Thbetyfu/Peruri-Chip-Satria-Chip/hardware-satria/rtl_sv/README.md

# RTL SystemVerilog

Padanan SystemVerilog dari `../rtl/*.v` (modul, port, dan perilaku identik).
Uji: `HDL=sv python tb/run.py [core|uart|random]`. Hasil verifikasi:
`../docs/verifikasi_sv.md`.
