Thbetyfu/Peruri-Chip-Satria-Chip/hardware-satria/docs/skematik/01_RTL_top_level.pdf

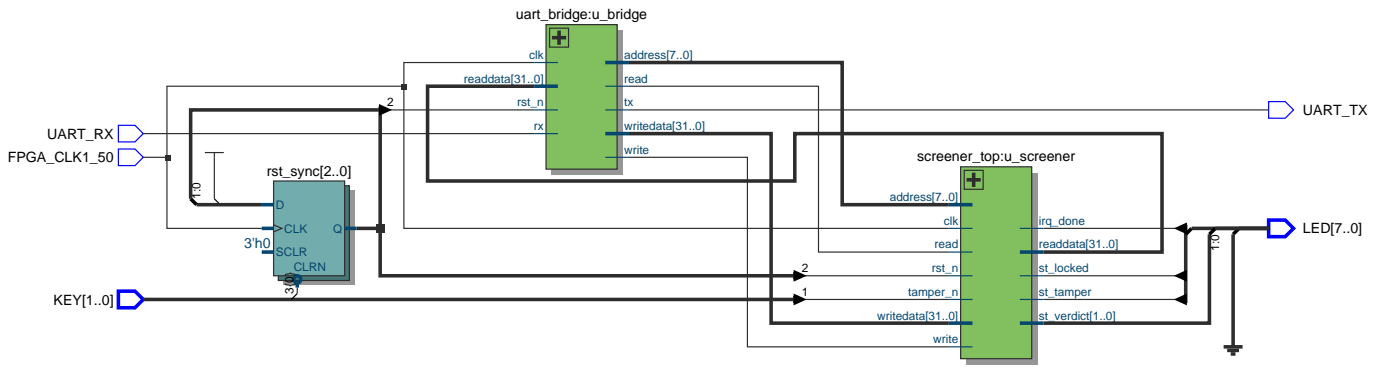
[picture p2: figure]
UART_RX FPGA_CLK1_50; KEY[1..0]; rst_sync[2..0] D; CLK; CLRN; SCLR 3'h0; uart_bridge:u_bridge; clk; rst_n; readdata[31..0]; read; write; address[7..0]; writedata[31..0]; screener_top:u_screener; tamper_n; irq_done; st_locked; st_tamper; st_verdict[1..0]; UART_TX; LED[7..0]
