Thbetyfu/Peruri-Chip-Satria-Chip/hardware-satria/docs/skematik/03_PostFit_top_level.pdf

### KEY[0..1]

### FPGA_CLK1_50

### UART_RX

### FPGA_CLK1_50~input

IO_IBUF I | O

### FPGA_CLK1_50~inputCLKENA0

### CLKCTRL

INCLK OUTCLK

### rst_sync[0]~feeder

### LOGIC_CELL_COMB

COMBOUT

### KEY[0]~input

IO_IBUF I | O

### rst_sync[0]

CLK

D
CLRN

Q

### rst_sync[1]

CLK

SDATA

CLRN

SLOAD 1'h1

Q

### rst_sync[2]

CLK

SDATA

CLRN

SLOAD 1'h1

Q

### rst_sync[2]~CLKENA0

### CLKCTRL

INCLK OUTCLK

### UART_RX~input

IO_IBUF I | O

### KEY[1]~input

IO_IBUF I | O

### uart_bridge:u_bridge

FPGA_CLK1_50~inputCLKENA0

rst_sync[2]~CLKENA0

screener_top:u_screener:readdata[0..31]

UART_RX~input

address[0..1]

address[2..7]

address[1]~DUPLICATE

read

tx

write

writedata[0..3]

writedata[5..7]

writedata[8..9]

writedata[11..18]

writedata[19..23]

writedata[25..31]

writedata[3]~DUPLICATE

writedata[4]

writedata[4]~DUPLICATE

writedata[7]~DUPLICATE

writedata[9]~DUPLICATE

writedata[10]

writedata[10]~DUPLICATE

writedata[18]~DUPLICATE

writedata[23]~DUPLICATE

writedata[24]

writedata[24]~DUPLICATE

writedata[31]~DUPLICATE

### ~GND

### LOGIC_CELL_COMB

COMBOUT

### screener_top:u_screener

FPGA_CLK1_50~inputCLKENA0 KEY[1]~input

rst_sync[2]~CLKENA0

uart_bridge:u_bridge:address[0..1]

uart_bridge:u_bridge:address[2..7] uart_bridge:u_bridge:address[1]~DUPLICATE

uart_bridge:u_bridge:read

uart_bridge:u_bridge:write uart_bridge:u_bridge:writedata[0..3]

uart_bridge:u_bridge:writedata[5..7]

uart_bridge:u_bridge:writedata[8..9]

uart_bridge:u_bridge:writedata[11..18]

uart_bridge:u_bridge:writedata[19..23]

uart_bridge:u_bridge:writedata[25..31] uart_bridge:u_bridge:writedata[3]~DUPLICATE

uart_bridge:u_bridge:writedata[4] uart_bridge:u_bridge:writedata[4]~DUPLICATE

uart_bridge:u_bridge:writedata[7]~DUPLICATE

uart_bridge:u_bridge:writedata[9]~DUPLICATE

uart_bridge:u_bridge:writedata[10] uart_bridge:u_bridge:writedata[10]~DUPLICATE

uart_bridge:u_bridge:writedata[18]~DUPLICATE

uart_bridge:u_bridge:writedata[23]~DUPLICATE

uart_bridge:u_bridge:writedata[24] uart_bridge:u_bridge:writedata[24]~DUPLICATE

uart_bridge:u_bridge:writedata[31]~DUPLICATE

~GND

done_flag

key_vault:u_vault:locked

key_vault:u_vault:tamper

readdata[0..31]

verdict[0..1]

### UART_TX~output

IO_OBUF I | O

### LED[2]~output

IO_OBUF I | O

### LED[3]~output

IO_OBUF I | O

### LED[7]~output

IO_OBUF I | O

### LED[0]~output

IO_OBUF I | O

### LED[1]~output

IO_OBUF I | O

### LED[4]~output

IO_OBUF I 1'h0 | O

### LED[5]~output

IO_OBUF I 1'h0 | O

### LED[6]~output

IO_OBUF I 1'h0 | O

### UART_TX

### LED[0..7]

0 | 1 | 01
