Thbetyfu/Peruri-Chip-Satria-Chip/hardware-satria/docs/skematik/04_PostFit_rule_engine_gerbang.pdf

# rule_engine:u_rule

# cfg_amt_hi[4..29] cfg_amt_hi[2..3]~DUPLICATE

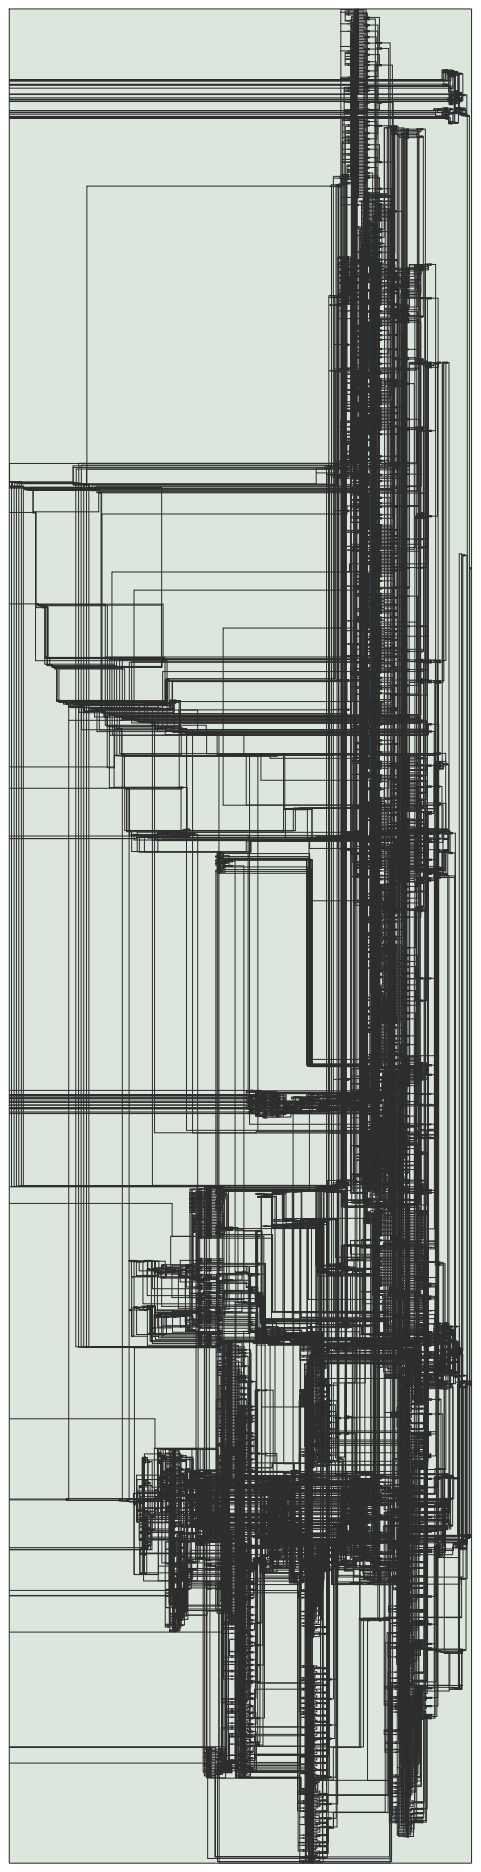
[picture p3: page 1]
acct_idx[0..37]; acct_idx[39..47]; acct_idx[37]~DUPLICATE; acct_idx[38]; acct_idx[38]~DUPLICATE; cfg_amt_hi[0]~DUPLICATE; cfg_amt_hi[1]; cfg_amt_hi[30]~DUPLICATE; cfg_amt_hi[31] cfg_amt_lo[0..12] cfg_amt_lo[13..14]; cfg_amt_lo[16..19] cfg_amt_lo[21..28]; cfg_amt_lo[29..31]; cfg_amt_lo[12]~DUPLICATE; cfg_amt_lo[15]~DUPLICATE; cfg_amt_lo[20]~DUPLICATE; cfg_amt_lo[28]~DUPLICATE; cfg_vel[0..15]; cfg_window[1..3]; cfg_window[0]; cfg_window[0]~DUPLICATE; cfg_window[3]~DUPLICATE; cfg_window[4]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

DATAA DATAB DATAC
LessThan5~27
DATAD

LOGIC_CELL_COMB
LessThan5~7

LessThan5~28

COUT SUMOUT Add4~17
CIN 1'h0 DATAA DATAC
COUT SUMOUT
COUT SUMOUT Add6~17

COUT SUMOUT Add2~9
CIN 1'h0 DATAA DATAD
CIN
DATAA DATAC
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
