Thbetyfu/Peruri-Chip-Satria-Chip/fig/block_diagram.png

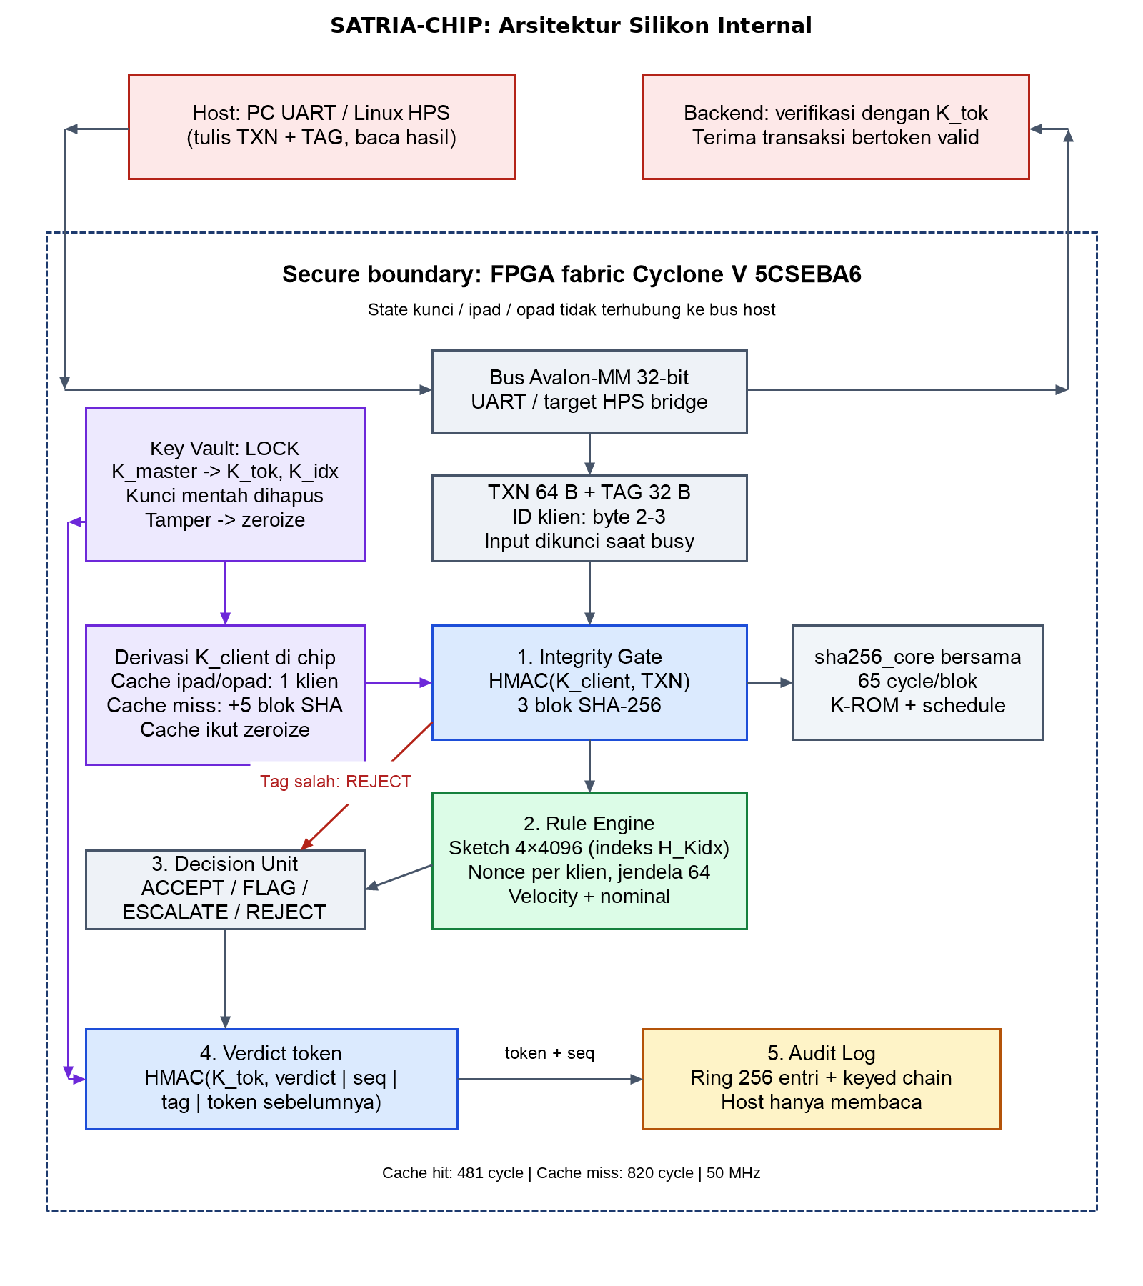
fig/block_diagram.png
