Thbetyfu/Peruri-Chip-Satria-Chip/fig/timing_transaksi.png

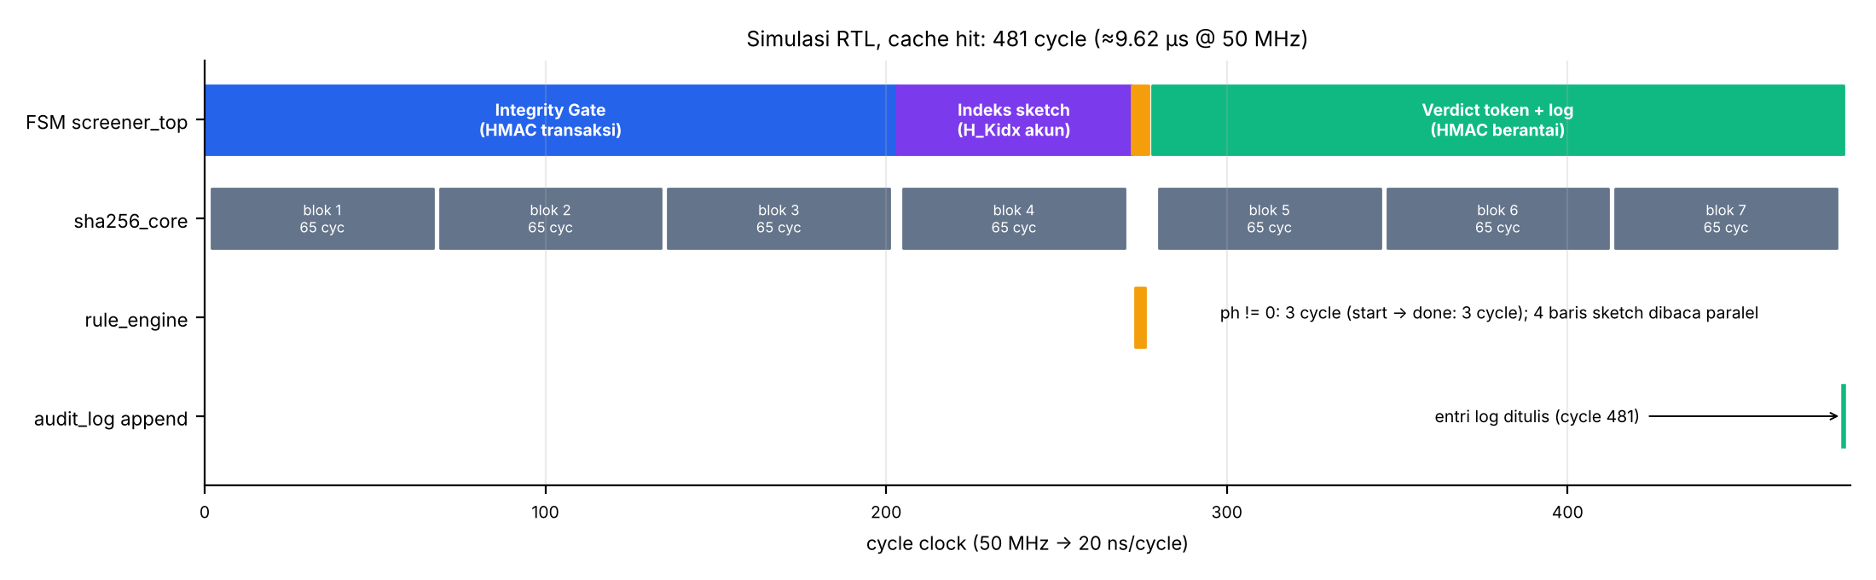
fig/timing_transaksi.png
