Thbetyfu/Peruri-Chip-Satria-Chip/hardware-satria/docs/skematik/04_cuplikan_zoom_rule_engine.png

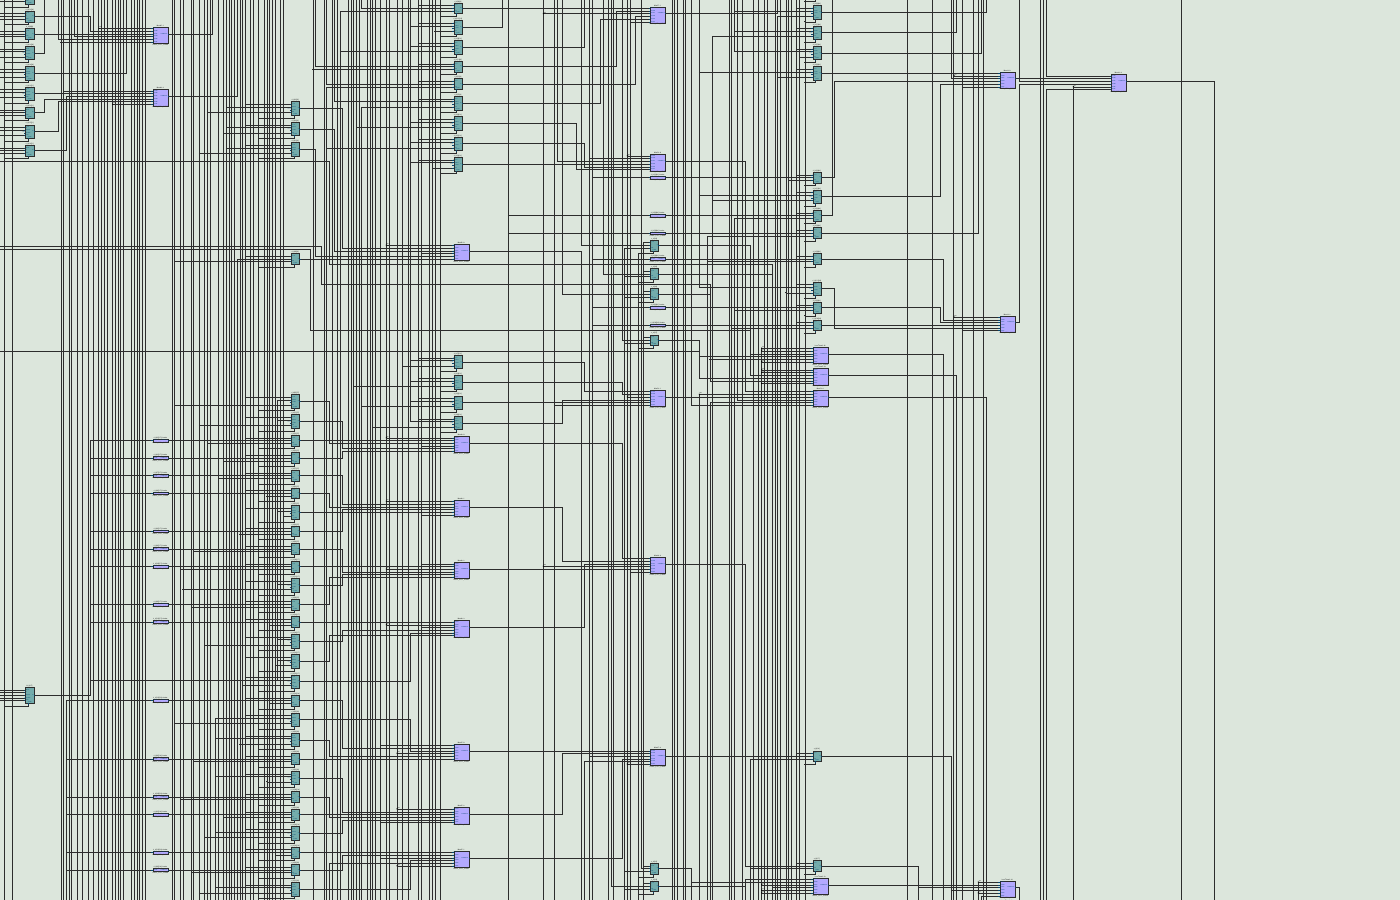
hardware-satria/docs/skematik/04_cuplikan_zoom_rule_engine.png
