Thbetyfu/Peruri-Chip-Satria-Chip/hardware-satria/docs/skematik/02_RTL_screener_top_lengkap.pdf

# screener_top:u_screener

KEY[1..0] | LED[7..0] UART_RX | UART_TX

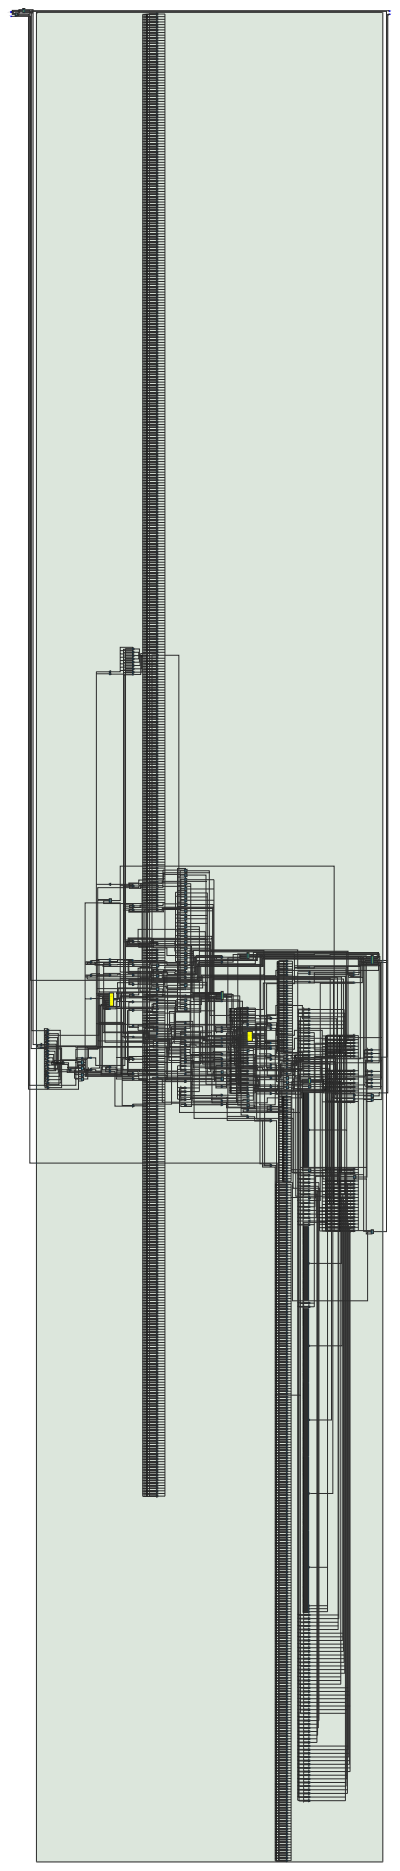
[picture p7: page 1]
clk; read; rst_n; tamper_n; write; address[7..0]; writedata[31..0]; irq_done; st_locked; st_tamper; readdata[31..0]; st_verdict[1..0]; rst_sync[2..0] D; CLKCLRN; SCLR 3'h0; uart_bridge:u_bridge; txwrite; address[7..0] writedata[31..0]; 1'h0 CIN; Add0; OUT[31..0]; Decoder0; OUT[15..0]; Decoder1; OUT[7..0]; Decoder2; OUT[3..0]; Decoder3; OUT[255..0] =Equal0; OUT; =Equal1; =Equal2; =Equal3; OUT =Equal4; OUT =Equal5; OUT =Equal6; OUT =Equal7; =Equal8; OUT =Equal9; =Equal10; OUT <; 1'h1 CIN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
