Thbetyfu/Peruri-Chip-Satria-Chip/hardware-satria/rtl_sv/uart_bridge.sv

// SPDX-License-Identifier: LicenseRef-Proprietary
// SPDX-FileCopyrightText: Copyright (c) 2026 Tim Paket Kulit 12k, Telkom University. All rights reserved.
// uart_bridge.v - jembatan UART 8N1 -> bus register screener (untuk demo PC).
//
// Protokol (byte):
//   Tulis: 'W' addr d3 d2 d1 d0   -> balasan 'K'
//   Baca : 'R' addr               -> balasan d3 d2 d1 d0
// Pada DE10-Nano produksi, jembatan ini digantikan HPS-to-FPGA lightweight
// bridge (Linux di ARM HPS berperan sebagai host server).
// SystemVerilog (IEEE 1800-2017) — padanan fungsional rtl/uart_bridge.v; diverifikasi
// dengan testbench & golden model yang sama (lihat docs/verifikasi_sv.md).

`default_nettype none

module uart_bridge #(
    parameter CLK_HZ = 50_000_000,
    parameter BAUD   = 115_200
) (
    input  logic        clk,
    input  logic        rst_n,
    input  logic        rx,
    output logic         tx,
    output logic  [7:0]  address,
    output logic         write,
    output logic  [31:0] writedata,
    output logic         read,
    input  logic [31:0] readdata
);
  localparam integer DIV_I = CLK_HZ / BAUD;
  localparam [15:0] DIV = DIV_I[15:0];
  localparam [15:0] DIV_HALF = DIV >> 1;
  localparam [15:0] DIV_M1 = DIV - 16'd1;

  // ---------------- RX ----------------
  logic [1:0]  rx_s;
  logic [15:0] rx_cnt;
  logic [3:0]  rx_bit;
  logic [7:0]  rx_sh;
  logic        rx_busy, rx_valid;
  logic [7:0]  rx_data;

  always_ff @(posedge clk or negedge rst_n) begin
    if (!rst_n) begin
      rx_s <= 2'b11; rx_cnt <= 0; rx_bit <= 0; rx_sh <= 0;
      rx_busy <= 0; rx_valid <= 0; rx_data <= 0;
    end else begin
      rx_s <= {rx_s[0], rx};
      rx_valid <= 1'b0;
      if (!rx_busy) begin
        if (!rx_s[1]) begin rx_busy <= 1; rx_cnt <= DIV_HALF; rx_bit <= 0; end
      end else if (rx_cnt != 0) begin
        rx_cnt <= rx_cnt - 1;
      end else begin
        rx_cnt <= DIV_M1;
        if (rx_bit == 0) begin
          if (rx_s[1]) rx_busy <= 0;            // start bit palsu
          else rx_bit <= 1;
        end else if (rx_bit <= 8) begin
          rx_sh <= {rx_s[1], rx_sh[7:1]}; rx_bit <= rx_bit + 1;
        end else begin
          rx_busy <= 0;
          if (rx_s[1]) begin rx_valid <= 1; rx_data <= rx_sh; end
        end
      end
    end
  end

  // ---------------- TX ----------------
  logic [15:0] tx_cnt;
  logic [3:0]  tx_bit;
  logic [9:0]  tx_sh;
  logic        tx_busy, tx_go;
  logic [7:0]  tx_byte;

  always_ff @(posedge clk or negedge rst_n) begin
    if (!rst_n) begin
      tx <= 1; tx_cnt <= 0; tx_bit <= 0; tx_sh <= 10'h3FF; tx_busy <= 0;
    end else begin
      if (!tx_busy) begin
        if (tx_go) begin
          tx_sh <= {1'b1, tx_byte, 1'b0}; tx_busy <= 1; tx_bit <= 0; tx_cnt <= 0;
        end
      end else if (tx_cnt != 0) begin
        tx_cnt <= tx_cnt - 1;
      end else begin
        if (tx_bit == 10) tx_busy <= 0;
        else begin
          tx <= tx_sh[0]; tx_sh <= {1'b1, tx_sh[9:1]};
          tx_bit <= tx_bit + 1; tx_cnt <= DIV_M1;
        end
      end
    end
  end

  // ---------------- protokol ----------------
  localparam P_CMD = 0, P_ADDR = 1, P_DATA = 2, P_RDWAIT = 3, P_SEND = 4, P_WAITTX = 5, P_RDWAIT2 = 6;
  logic [2:0]  ps;
  logic        is_wr;
  logic [1:0]  nb;
  logic [31:0] resp;
  logic [2:0]  nsend;

  always_ff @(posedge clk or negedge rst_n) begin
    if (!rst_n) begin
      ps <= P_CMD; is_wr <= 0; nb <= 0; resp <= 0; nsend <= 0;
      address <= 0; write <= 0; writedata <= 0; read <= 0; tx_go <= 0; tx_byte <= 0;
    end else begin
      write <= 0; read <= 0; tx_go <= 0;
      case (ps)
        P_CMD:  if (rx_valid) begin
                  if (rx_data == 8'h57) begin is_wr <= 1; ps <= P_ADDR; end
                  else if (rx_data == 8'h52) begin is_wr <= 0; ps <= P_ADDR; end
                end
        P_ADDR: if (rx_valid) begin
                  address <= rx_data;
                  if (is_wr) begin nb <= 0; ps <= P_DATA; end
                  else begin read <= 1; ps <= P_RDWAIT; end
                end
        P_DATA: if (rx_valid) begin
                  writedata <= {writedata[23:0], rx_data};
                  nb <= nb + 1;
                  if (nb == 2'd3) begin
                    write <= 1; resp <= {8'h4B, 24'd0}; nsend <= 1; ps <= P_SEND;
                  end
                end
        P_RDWAIT:  ps <= P_RDWAIT2;                    // readdata terdaftar 1 cycle
        P_RDWAIT2: begin resp <= readdata; nsend <= 4; ps <= P_SEND; end
        P_SEND: if (!tx_busy && !tx_go) begin
                  tx_byte <= resp[31:24]; resp <= {resp[23:0], 8'h00};
                  tx_go <= 1; nsend <= nsend - 1; ps <= P_WAITTX;
                end
        P_WAITTX: if (tx_busy) ps <= (nsend == 0) ? P_CMD : P_SEND;
        default: ps <= P_CMD;
      endcase
    end
  end
endmodule

`default_nettype wire
