Thbetyfu/Peruri-Chip-Satria-Chip/(commit log)

2026-10-07 SATRIA-CHIP: RTL, verifikasi, bitstream, dan dasbor demo
    Isi awal repositori proposal PERURI Chip Hackathon 2026 (Tim Paket Kulit 12k):
    - hardware-satria/: RTL Verilog-2005, golden model, testbench cocotb,
    proyek Quartus + bitstream screener.sof, laporan fit/sta/power, log simulasi
    - demo_dashboard/: dasbor demo tanpa dependensi; vonis dihitung golden model
    - aml_gateway_simulator.py: kunci klien diturunkan sama dengan golden/RTL
    - str_generator.py: penyusun draf LTKM XML bergaya goAML
    - test_dashboard_api.py: tes engine, kunci gateway, dan HTTP
    Claude-Session: https://claude.ai/code/session_01EmYGY8r41WFqH1Si4uF4Mj
2026-10-07 Bukti verifikasi: regresi acak 10.000 transaksi bit-exact
    Eksekusi ulang dengan Icarus Verilog 12.0 + cocotb 2.1.0:
    - core 13/13 lulus, UART end-to-end 1/1 lulus
    - regresi acak 10.000/10.000 transaksi bit-exact vs golden model
    (seed 20261007, 200 akun / 64 slot, 5 klien), 0 gagal
    Log disimpan di hardware-satria/docs/; catatan verifikasi dan README diperbarui.
    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
2026-10-07 Gambar wiring DE10-Nano versi skema teknik (Rev 2)
    Header JP1 2x20 dengan pin yang dipakai/terlarang ditandai, jalur kabel
    tanpa persilangan, tabel koneksi dan peta LED/KEY dari screener.qsf,
    serta blok judul.
    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
2026-10-07 Perbaiki line ending skrip formal dan catatan throughput UART
    - run_formal.sh dan key_isolation.ys dikonversi CRLF -> LF agar jalan di Linux
    - .gitattributes: paksa LF untuk *.sh dan *.ys
    - README: angka 121.654 transaksi/detik ditegaskan sebagai kapasitas core;
    demo via UART 115200 baud sekitar 20-40 transaksi/detik
    Claude-Session: https://claude.ai/code/session_01Nt5U2JFoKsj7D2deyLU3ou
2026-10-07 Velocity fail-safe: Count-Min Sketch berkunci + anti-replay per klien
    Uji serangan menemukan dua rekening yang berbagi slot pada tabel 64 slot
    dapat bergantian tanpa pernah kena FLAG, dan watermark per slot menolak
    transaksi sah bila jam sumber berselisih.
    - rule_engine: Count-Min Sketch 4x4096 (M10K), epoch 2^CFG_WIN_SHIFT dtk,
    perkiraan = min(cur+prev) antar baris; tidak pernah menghitung kurang.
    Anti-replay nomor urut per klien (id 0..15) dengan jendela 64.
    Pipeline 4 cycle; sketch disapu setelah reset (STATUS bit 4).
    - key_vault: turunkan K_idx = HMAC(K_master, PERURI-INDEX-KEY-v1) saat LOCK.
    - hmac_engine: mode HASH1 (1 blok) untuk indeks sketch berkunci.
    - golden model, testbenc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
    [demo_uart.py, hmac_engine.v, key_vault.v, make_fig_timing.py, rule_engine.v]
2026-10-07 Tambah RTL SystemVerilog (rtl_sv) dan netlist post-fit Quartus
    - rtl_sv/*.sv: padanan SystemVerilog, lulus 16/16 core, UART, dan
    regresi 10.000 transaksi bit-exact (HDL=sv tb/run.py)
    - netlist_quartus/screener_postfit.vo: netlist sel Cyclone V dari EDA
    Netlist Writer (10.013 LUT, 11.364 FF, 104 M10K)
    Claude-Session: https://claude.ai/code/session_01Nt5U2JFoksj7D2deylu3ou
